fruchti/arachnouphobia/kicad/export/panel-B.Cu.pdf

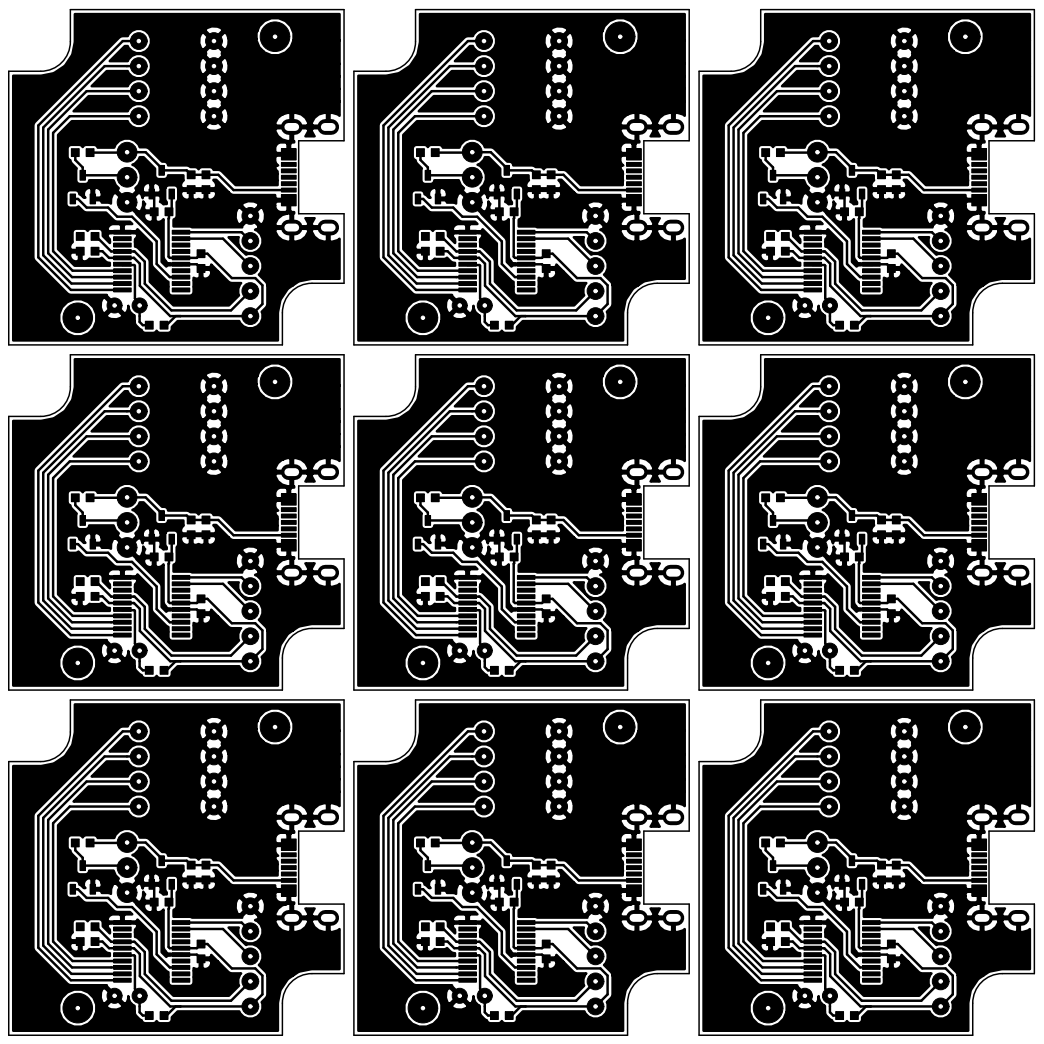
[picture p1: page 1]
