fruchti/arachnouphobia/kicad/arachnouphobia.kicad_pcb

## KiCad design kicad/arachnouphobia.kicad_pcb (2019-11-08)

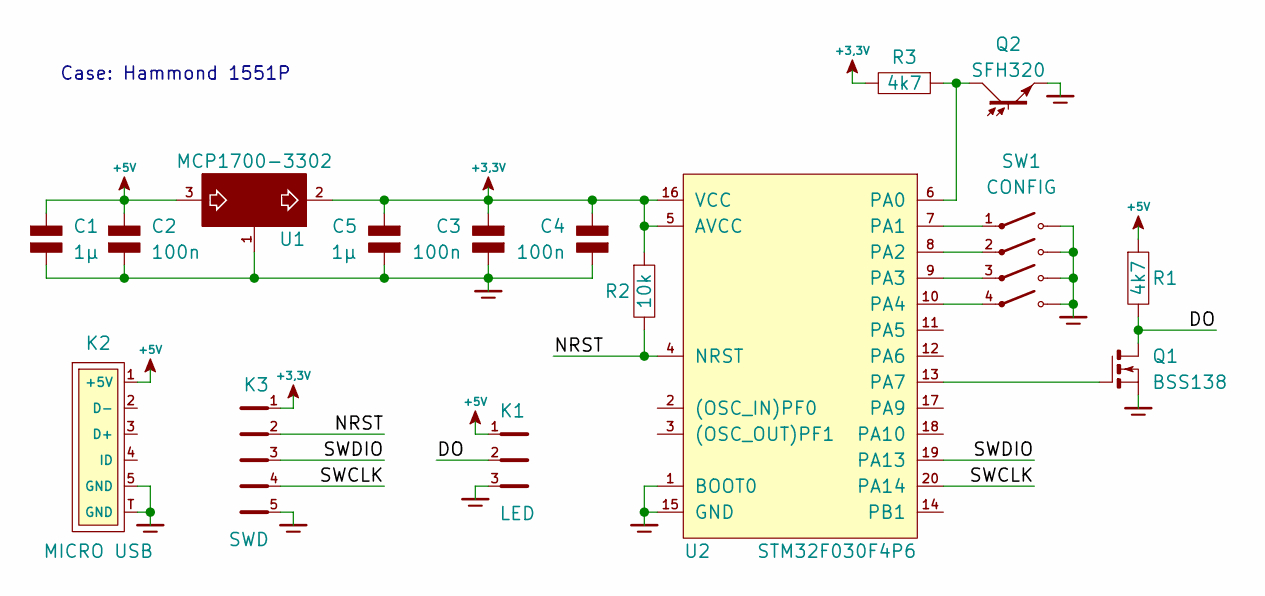
[picture p2: schematic arachnouphobia.sch]

Parts:
C1, C5: 1µ; 0603_B
C2, C3, C4: 100n; 0603_B
K1: LED; PSS254-3W
K2: MICRO USB; USB_B_MICRO_W_SMT_AMPHENOL_10103593
K3: SWD; PINHEAD_1_5
Q1: BSS138; SOT23
Q2: SFH320; LED_5mm_100
R1, R3: 4k7; 0603_B
R2: 10k; 0603_B
SW1: CONFIG; DIP8_300
U1: MCP1700-3302; SOT23
U2: STM32F030F4P6; TSSOP20

Connections:
+3,3V: C3.1, C4.1, C5.1, K3.1, R2.1, R3.2, U1.2 (VO), U2.5 (AVCC), U2.16 (VCC)
+5V: C1.1, C2.1, K1.1, K2.1 (+5V), R1.1, U1.3 (VI)
/DO: K1.2, Q1.3 (D), R1.2
/NRST: K3.2, R2.2, U2.4 (NRST)
/SWCLK: K3.4, U2.20 (PA14)
/SWDIO: K3.3, U2.19 (PA13)
GND: C1.2, C2.2, C3.2, C4.2, C5.2, K1.3, K2.5 (GND), K2.T (GND), K3.5, Q1.2 (S), Q2.1 (E), SW1.5, SW1.6, SW1.7, SW1.8, U1.1 (GND), U2.1 (BOOT0), U2.15 (GND)
unnamed: Q1.1 (G), U2.13 (PA7)
unnamed: Q2.2 (C), R3.1, U2.6 (PA0)
unnamed: SW1.1, U2.7 (PA1)
unnamed: SW1.2, U2.8 (PA2)
unnamed: SW1.3, U2.9 (PA3)
unnamed: SW1.4, U2.10 (PA4)

Notes on the sheet:
Case: Hammond 1551P

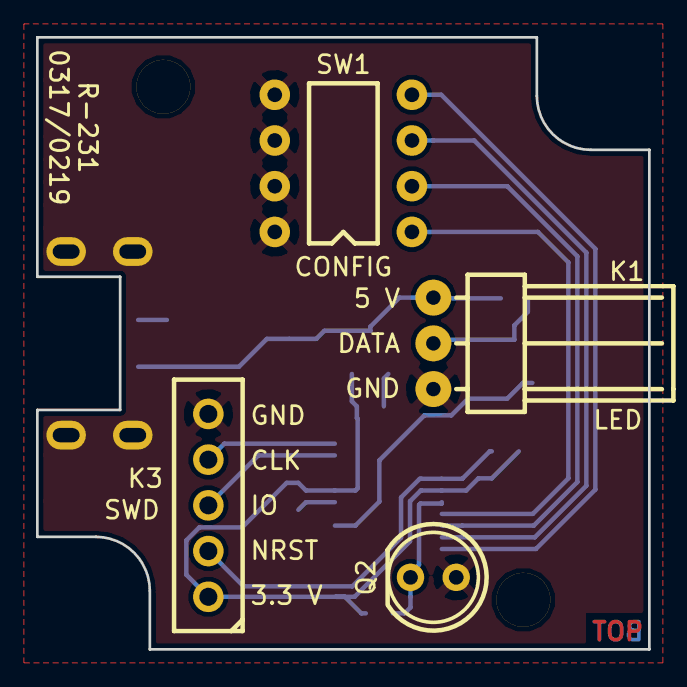
[picture p3: board arachnouphobia.kicad_pcb from above]

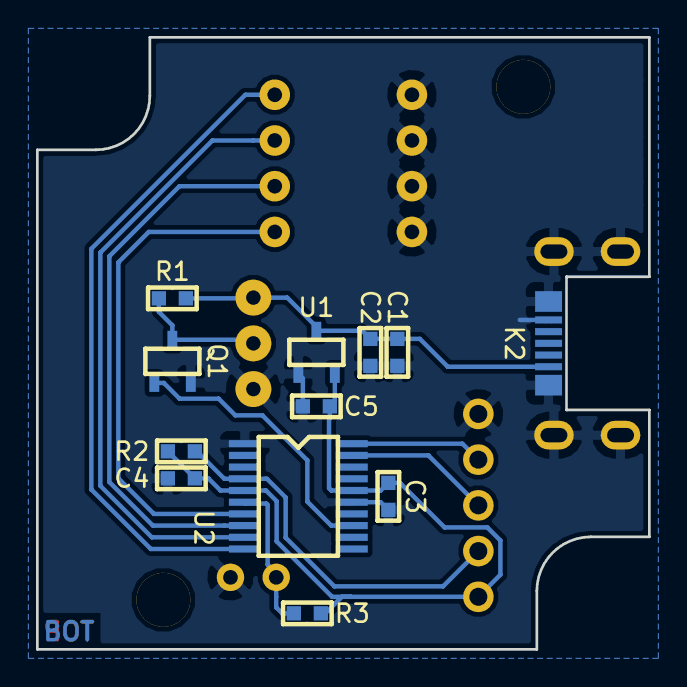
[picture p4: board arachnouphobia.kicad_pcb from below]

Board: 2 copper layers, 34.0 x 34.0 mm, 18 parts (12 on the bottom side), 13 nets.

Other parts of the board:
HOLE_3mm, HOLE_3mm#2: VAL**; HOLE_3mm
