fruchti/arachnouphobia/stm32f030f4p6/src/pinning.h

#ifndef PINNING_H_
#define PINNING_H_

#define PIN_SENSOR      0   // PA0 - light sensor
#define PIN_DIP_1       4   // PA1 - DIP switch 1
#define PIN_DIP_2       3   // PA2 - DIP switch 2
#define PIN_DIP_3       2   // PA3 - DIP switch 3
#define PIN_DIP_4       1   // PA4 - DIP switch 4

#endif
