fruchti/arachnouphobia/(commit log)

2019-11-08 Add KiCad schematic and layout
    [arachnouphobia.kicad_pcb, arachnouphobia.sch]
2019-11-08 Add STM32F0 firmware
    [flash.cfg]
2019-11-08 Add copper layer PDF and gerber files
    [arachnorepel-B.Cu.gbl, arachnorepel-B.Mask.gbs, arachnorepel-B.SilkS.gbo, arachnorepel-Edge.Cuts.gm1, arachnorepel-F.Cu.gtl, arachnorepel-F.Mask.gts, arachnorepel-F.SilkS.gto, arachnorepel-NPTH.drl]
